John-Titor/TachSpeedo/board/TachSpeedo.brd

## EAGLE design board/TachSpeedo.brd (2015-06-01)

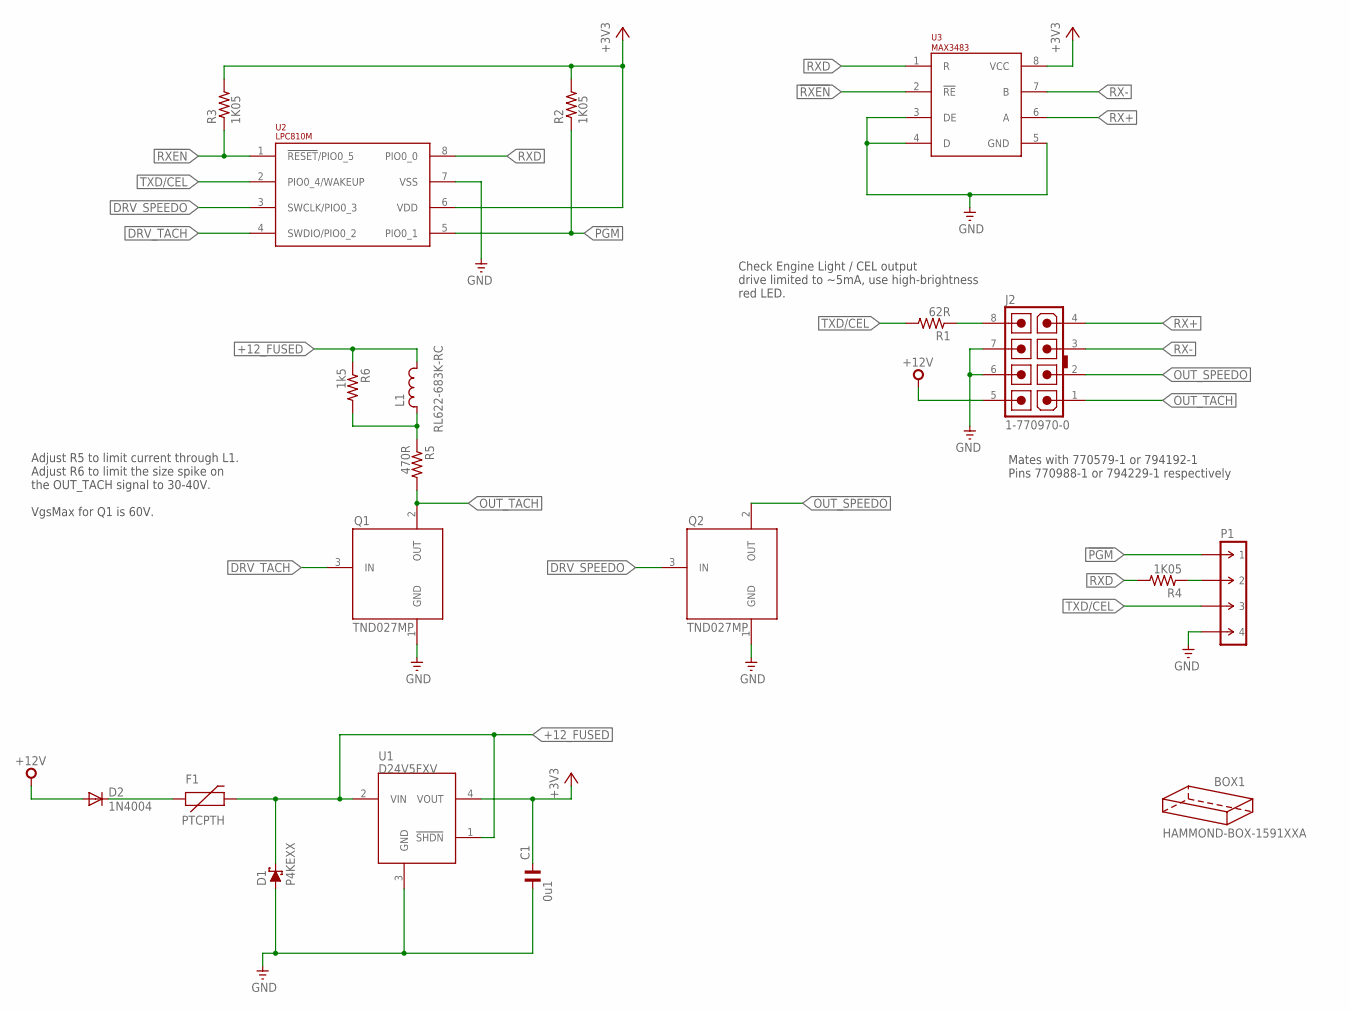
[picture p1: schematic TachSpeedo.sch]

Parts:
BOX1: HAMMOND-BOX-1591XXA; 1591XXA; PARTNO 1591XXAFLBK
C1: 0u1; C025-024X044; PARTNO FK18X7R1E104K
D1: P4KEXX; DO41-10; PARTNO P4KE30CA
D2: 1N4004; DO41-10; PARTNO 1N4004
F1: PTCPTH; PTC; PARTNO 600R150-RBZR
J2: 1-770970-0; PARTNO 1-770970-0
L1: RL622-683K-RC; RL622; PARTNO RL622-563K-RC
P1: M-1X04-SIP-100-40; SIP-100-04-40; PARTNO 961104-6404-AR
Q1, Q2: TND027MP; TO-92; PARTNO TND027MP-AZ
R1: 62R; 0207/10; PARTNO MFR-25FTE52-62R
R2, R3, R4: 1K05; 0207/10; PARTNO MFR-25FBF52-1K05
R5: 470R; 0207/10; PARTNO MFR-25FBF52-470R
R6: 1k5; 0207/10; PARTNO MFR-25FRF52-1K5
U1: D24V5FXV; SIP-100-04-40
U2: LPC810M; DIL08; PARTNO LPC810M021FN8FP
U3: MAX3483; DIL08; PARTNO MAX3483CPA+

Connections:
!PGM: P1.1, R2.1, U2.5 (PIO0_1)
!RXEN: R3.1, U2.1 (!RESET!/PIO0_5), U3.2 (!RE)
+3V3: C1.1, R2.2, R3.2, U1.4 (VOUT), U2.6 (VDD), U3.8 (VCC)
+12V: D2.A, J2.5
+12_FUSED: D1.C, F1.P$2 (2), L1.2, R6.1, U1.1 (!SHDN), U1.2 (VIN)
DRV_SPEEDO: Q2.3 (IN), U2.3 (SWCLK/PIO0_3)
DRV_TACH: Q1.3 (IN), U2.4 (SWDIO/PIO0_2)
GND: C1.2, D1.A, J2.6, J2.7, P1.4, Q1.1 (GND), Q2.1 (GND), U1.3 (GND), U2.7 (VSS), U3.3 (DE), U3.4 (D), U3.5 (GND)
unnamed: D2.C, F1.P$1 (1)
unnamed: P1.2, R4.1
unnamed: J2.8, R1.1
unnamed: L1.1, R5.1, R6.2
OUT_SPEEDO: J2.2, Q2.2 (OUT)
OUT_TACH: J2.1, Q1.2 (OUT), R5.2
RX+: J2.4, U3.6 (A)
RX-: J2.3, U3.7 (B)
RXD: R4.2, U2.8 (PIO0_0), U3.1 (R)
TXD/CEL: P1.3, R1.2, U2.2 (PIO0_4/WAKEUP)

Notes on the sheet:
Check Engine Light / CEL output drive limited to ~5mA, use high-brightness red LED.
Adjust R5 to limit current through L1. Adjust R6 to limit the size spike on the OUT_TACH signal to 30-40V. VgsMax for Q1 is 60V.
Mates with 770579-1 or 794192-1 Pins 770988-1 or 794229-1 respectively

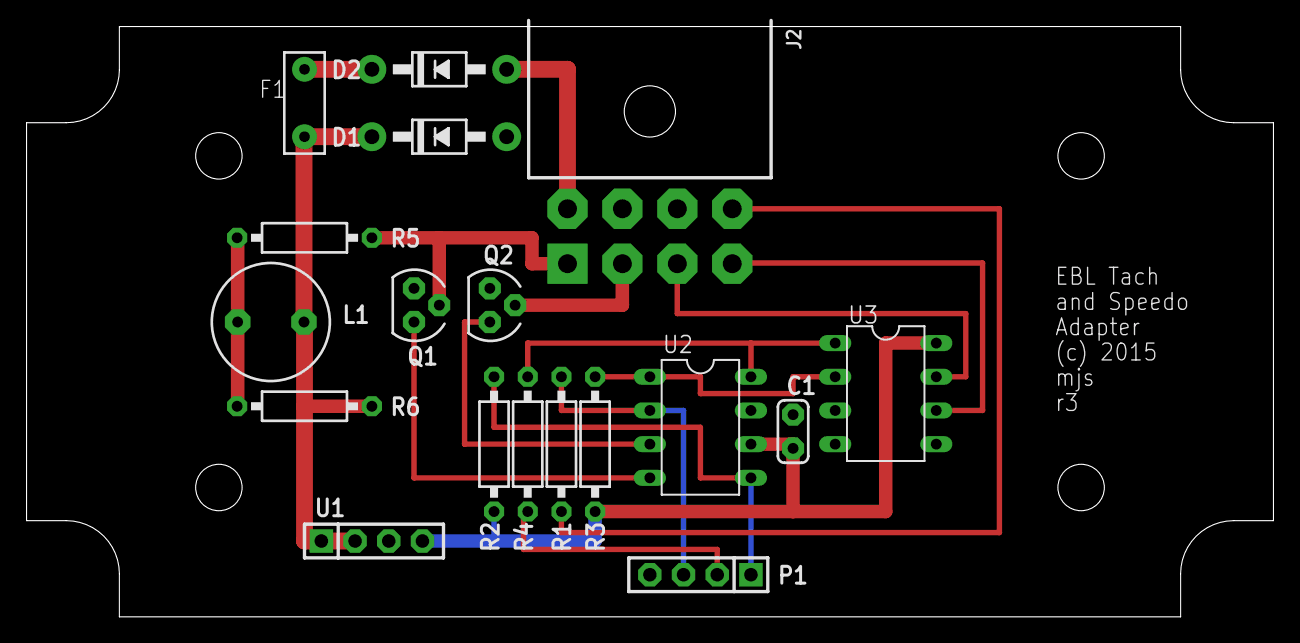
[picture p2: board TachSpeedo.brd from above]

Board: 2 copper layers, 94.0 x 44.5 mm, 19 parts (0 on the bottom side), 18 nets.
