John-Titor/TachSpeedo/main.cpp

// Copyright (c) 2015 Michael Smith, All Rights Reserved
//
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
//  o Redistributions of source code must retain the above copyright
//    notice, this list of conditions and the following disclaimer.
//  o Redistributions in binary form must reproduce the above copyright
//    notice, this list of conditions and the following disclaimer in
//    the documentation and/or other materials provided with the distribution.
//
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

#include <sysctl.h>
#include <pin.h>
#include <timer.h>
#include <uart.h>
#include <sct.h>

#include "ebl.h"

#define RXD     P0_0
#define TACH    P0_2
#define SPEEDO  P0_3
#define SES     P0_4
#define RXEN    P0_5

EBLDecoder EBL;

extern "C" int main();
static void output_rpm(unsigned rpm);
static void output_mph(unsigned mph);

int
main()
{
    Sysctl::init_24MHz();

    // SCT frequency output setup
    SCT::configure_fout();
    output_rpm(0);
    output_mph(0);

    // UART setup - note no TXD
    UART0_RXD.claim_pin(RXD);
    UART0.configure(57600);

    // Turn on the RS-485 receiver
    RXEN.configure(Pin::Output, Pin::PushPull).set(0);

    // Configure the SES LED
    SES.configure(Pin::Output, Pin::PushPull).set(0);

    // Startup sweep
    for (int step = 0; step <= 10; step++) {
        output_mph(step * 15);
        output_rpm(step * 700);
        Timer0.delay(150000 * 24);
        SES.toggle();
    }

    for (int step = 10; step >= 0; step--) {
        output_mph(step * 15);
        output_rpm(step * 700);
        Timer0.delay(150000 * 24);
        SES.toggle();
    }

    // Reset to sane state
    output_mph(0);
    output_rpm(0);
    SES.set(0);

    // spin forever
    for (;;) {
        unsigned c = '?';

        if (UART0.recv(c)) {

            EBL.decode(c);

            if (EBL.was_updated()) {
                output_rpm(EBL.engine_speed());
                output_mph(EBL.road_speed());
                SES << EBL.ses_set();
            }
        }
    }
}

//
// Tachometer output, assuming v8 (4 pulses per revolution):
// ---------------------------------------------------------
//
// interval = 1 / (rpm * 4 / 60)
// interval * (rpm * 4 / 60) = 1
// rpm * 4 / 60 = 1 / interval
// rpm * 4 = 60 / interval
// rpm = 15 / interval
//
// assuming 16-bit timer counting in microseconds, minimum interval is
// 2µs (7500000rpm), maximum is 128ms (117rpm).
//

static void
output_rpm(unsigned rpm)
{
    auto tach_us = 15000000UL / rpm;

    if (rpm == 0) {
        TACH << 0;
        TACH.configure(Pin::Output, Pin::PushPull);
        CTOUT_0.release_pin();
    } else {
        CTOUT_0.claim_pin(TACH);
        SCT::set_fout_period(0, tach_us);
    }
}

//
// Speedometer output, assuming 8 pulses per wheel revolution:
// -----------------------------------------------------------
//
// OE 930 rear wheel = 840 revs per mile
// 100 mph = 23.3 revs per second @ 8 pulses per rev = 186Hz.
//
// Coeffients below derived from experimental measurement.
// Linearity of the VDO speedometer is not very good; it reads
// a little fast at low speeds, and slow at higher speeds.
// The values here are good for the 30-90mph range where
// knowing your speed is important.
//
static void
output_mph(unsigned mph)
{
    static const int slope = 1750;
    static const int intercept = -3250;

    auto mpps = slope * (int)mph + intercept;

    // For speed values that can't be displayed (or if we
    // are not moving), turn off the output.
    if ((mph == 0) || (mpps <= 0)) {
        SPEEDO << 0;
        SPEEDO.configure(Pin::Output, Pin::PushPull);
        CTOUT_1.release_pin();
    } else {
        CTOUT_1.claim_pin(SPEEDO);
        auto speedo_us = 1000000000UL / mpps;
        SCT::set_fout_period(1, speedo_us);
    }
}
