John-Titor/TachSpeedo/(commit log)

2015-05-26 Initial checkin for the EBL tach/speedo adapter
    [TachSpeedo.brd, TachSpeedo.sch]
2015-05-31 EBL decoder and output controls for the r1 board
2015-06-01 Update in anticipation of the r3 board.
    [TachSpeedo.brd, TachSpeedo.sch]
